wwenbow/MEngCapstone/MEngPaper/titlepage.tex

\begin{titlepage}
\begin{center}

% Upper part of the page. The '~' is needed because \\
% only works if a paragraph has started.

    \textsc{\large University of California, Berkeley College of Engineering}\\[0.5cm]
    \textsc{\Large MASTER OF ENGINEERING - SPRING 2014}\\[1.5cm]

    \textsc{\large Electrical Engineering and Computer Sciences}\\[0.5cm]
    \textsc{\LARGE Humanoid Android Robot Subsystems}\\[0.5cm] 
    \textsc{\LARGE Wenbo Wang}\\[1.5cm]

\end{center}

\begin{flushleft}
{
    This Masters Project Paper fulfills the Master of Engineering degree
    requirement\\[0.5cm]
    Approved by:\\[0.5cm]
    1.  Capstone Project Advisor: \\[0.5cm]
    Signature: \underline{\hspace{7cm}} Date \underline{\hspace{3cm}}\\[0.5cm]
    Print Name: Donald Wroblewski\\
    Department: Fung Institute\\[1.5cm]

    2. Faculty Committee Member \#2: \\[0.5cm]
    Signature: \underline{\hspace{7cm}} Date \underline{\hspace{3cm}}\\[0.5cm]
    Print Name: Ruzena Bajcsy\\
    Department: Electrical Engineering and Computer Sciences\\
}
\end{flushleft}

\end{titlepage}
