wwenbow/MEngCapstone/Diagrams.pptx

Right Leg Right Side View

Left Leg Left Side View

Ch0

P2500

P500

Ch2

P1700

P2500

P500

P1200

Ch1

Right Leg Right Side View

P1500

Ch3

P1500

P2500

P2500

P1500

Ch5

P2300

P1200

P1500

Ch16

P2500

Ch18

P500

P2500

P500

P1200

Ch17

Left Leg Left Side View

Ch19

P1500

P500

P1700

P1500

Ch4

Ch20

P500

Ch21

P1200

P2300

P1500

P1500

## Slide 2
