wwenbow/MEngCapstone/UBW32_MX795_v26_sch.pdf

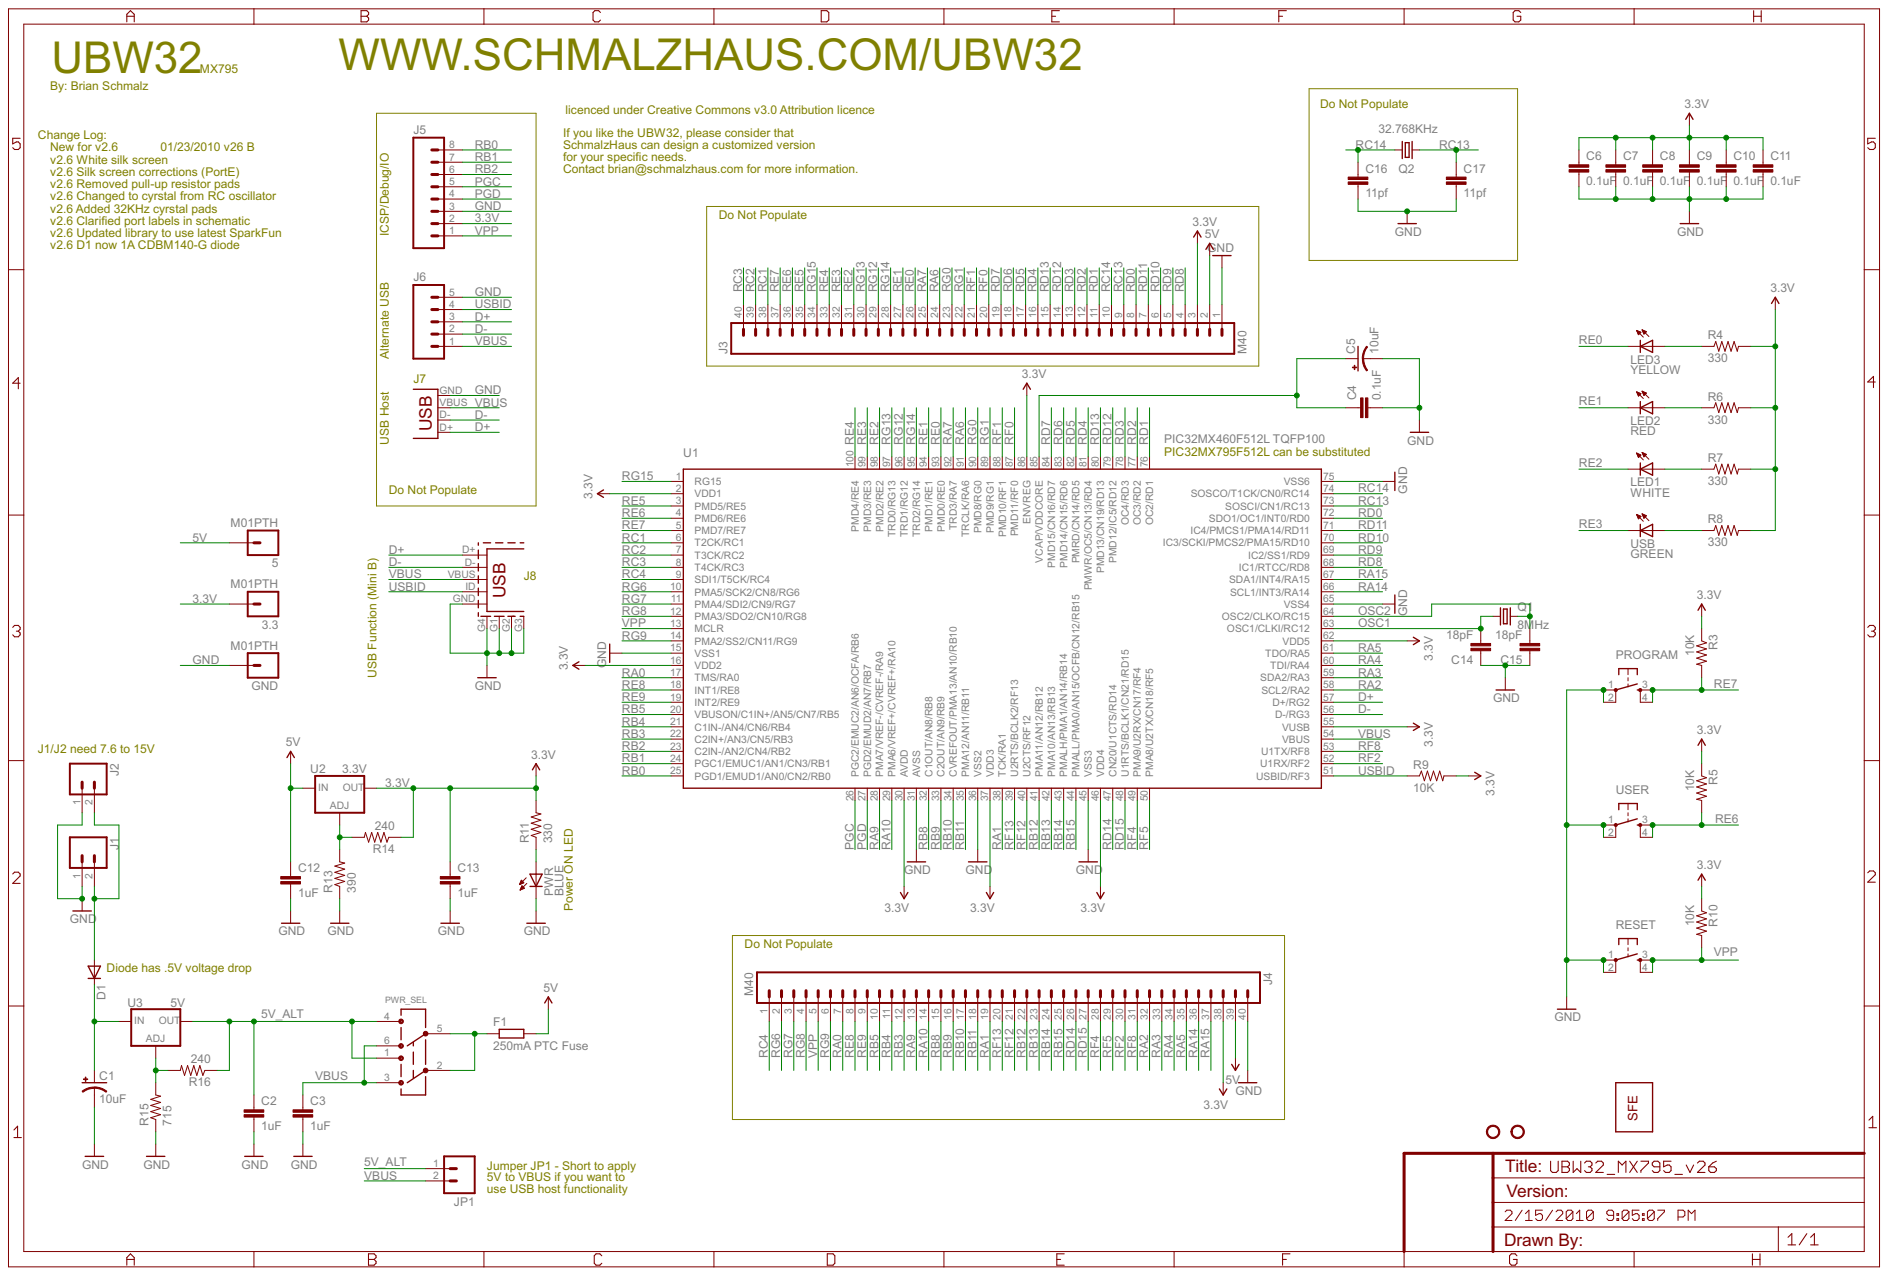
[picture p10: page 1]

By: Brian Schmalz Change Log: v2.6 White silk screen

licenced under Creative Commons v3.0 Attribution licence

If you like the UBW32, please consider that SchmalzHaus can design a customized version

ICSP/Debug/IO Alternate USB USB Host USB Function (Mini B)

for your specific needs. Contact brian@schmalzhaus.com for more information.

v2.6 Silk screen corrections (PortE) v2.6 Removed pull-up resistor pads

v2.6 Changed to cyrstal from RC oscillator v2.6 Added 32KHz cyrstal pads

v2.6 Clarified port labels in schematic
v2.6 Updated library to use latest SparkFun
v2.6 D1 now 1A CDBM140-G diode

Diode has .5V voltage drop

Jumper JP1 - Short to apply
5V to VBUS if you want to
use USB host functionality

Drawn By: Title: Version:
