wwenbow/MEngCapstone/MPLABprojects/MPU6050/shared.h

extern char GYRO_XOUT_H;
extern char GYRO_XOUT_L;
extern char GYRO_YOUT_H;
extern char GYRO_YOUT_L;
extern char GYRO_ZOUT_H;
extern char GYRO_ZOUT_L;
extern char GYRO_XOUT_OFFSET_1000SUM;
extern char GYRO_YOUT_OFFSET_1000SUM;
extern char GYRO_ZOUT_OFFSET_1000SUM;
extern char GYRO_XOUT_OFFSET;
extern char GYRO_YOUT_OFFSET;
extern char GYRO_ZOUT_OFFSET;
extern char ACCEL_XOUT_H;
extern char ACCEL_XOUT_L;
extern char ACCEL_YOUT_H;
extern char ACCEL_YOUT_L;
extern char ACCEL_ZOUT_H;
extern char ACCEL_ZOUT_L;
extern char ACCEL_XOUT;
extern char ACCEL_YOUT;
extern char ACCEL_ZOUT;
extern char ACCEL_XANGLE;
extern char ACCEL_YANGLE;
extern char ACCEL_ZANGLE;
extern char ACCEL_XOUT;
extern char ACCEL_YOUT;
extern char ACCEL_ZOUT;
extern char GYRO_XOUT_H;
extern char GYRO_XOUT_L;
extern char GYRO_YOUT_H;
extern char GYRO_YOUT_L;
extern char GYRO_ZOUT_H;
extern char GYRO_ZOUT_L;
extern char GYRO_XOUT;
extern char GYRO_XOUT_OFFSET;
extern char GYRO_YOUT;
extern char GYRO_YOUT_OFFSET;
extern char GYRO_ZOUT;
extern char GYRO_ZOUT_OFFSET;
extern char GYRO_XRATE;
extern char gyro_xsensitivity;
extern char GYRO_YRATE;
extern char gyro_ysensitivity;
extern char GYRO_ZRATE;
extern char gyro_zsensitivity;
