wwenbow/MEngCapstone/(commit log)

2014-03-20 Added header with pin numbers
2014-03-22 finished material methods
2014-04-10 Servo layout
2014-04-10 Servo struct
2014-05-01 Added leg controller with modes
2014-05-02 Revising report and fixed timing
    [LegController.pde]
